quochuy2204/magnetic-sensor/doc/ESD.pptx

## Magnetic contact switch for door

Embedded System Design

## Team members

Do Xuan Vy
e1801589
Tran Minh Hien
e1601116
Nguyen Quoc Huy
e16011

## Introduction

Automation
Remotely monitor door in houses and offices
Security
Data from the sensor can be used to trigger alarm in case of intrusion

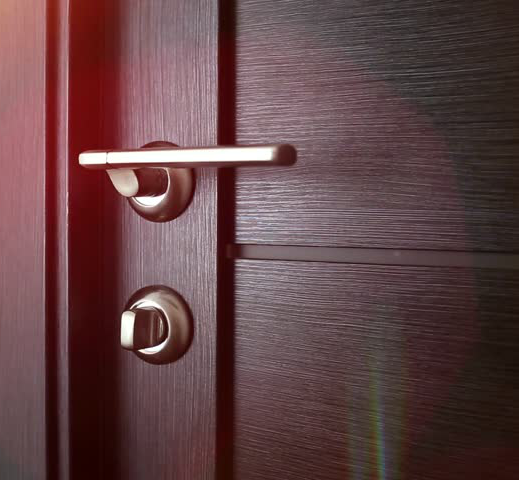
[picture p1: figure]

## Specification

Sensor
Communication
Magnetic sensor with STM32 controller
Wireless communication via XBee Modules

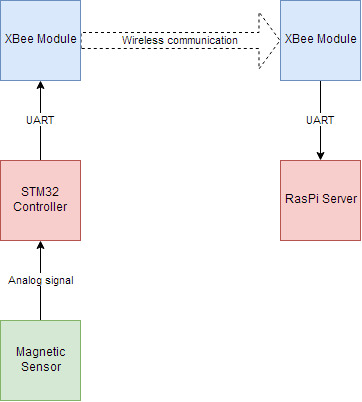
[picture p2: figure]

## Slide 5

## Slide 6

## Slide 7

## Slide 8

## Slide 9

## Slide 10

## Slide 11

## Slide 12

## Slide 13

## Slide 14

## Slide 15

## Slide 16

## Slide 17

## Slide 18

## Slide 19

## Slide 20
