quochuy2204/magnetic-sensor/ESD_report.pdf

GROUP 2

# Embedded Systems Design

Magnetic sensor for doors

April 2019

Do Xuan Vy (e1801589)

Tran Minh Hien (e1601116)

Nguyen Quoc Huy (e160)

VAASAN AMMATTIKORKEAKOULU
VAASA UNIVERSITY OF APPLIED SCIENCES Bachelor of Engineering

ABSTRACT

Author | Tran Minh Hien, Do Xuan Vy, Nguyen Quoc Huy
Title | Magnetic field sensor for doors
Year | 2019
Language | English
Pages | 40
Name of Supervisor | Jani Ahvonen

This is the report of Final project in Embedded Systems Design class. The goal of this course was to get student familiar with STMicroelectronics line of STM32 microcontroller, as well as developing some small projects by using STM32CubeMX software, Attolic TrueStudio for STM32 and vary of simple components such as LM741 operational amplifier, BC547 transistor, ESP-05 WiFi module …

In more detail for this final project, we will manufacture a magnetic measurement system which can be used to detect whether there is a magnetic field moving near the system. The system is a magnetic field measurement device which can detect electromagnetic fields strength spread from magnet stick on the door and then send wireless messages to subsystem which located one 30 meters away indoor and up to 90 meters outdoor by using XBee. At the first park of the system, Magnetic Field Processing (1), handle analog data from sensor then convert it to Hexadecimal. The second park receive the signal from (1), analysis and display the result on screen and alert user status of the door.

The idea of this product is to establish a security device into the doors, which can confirm if the door is closed and can notify users if they forget to close; and beyond, it can help users control the opening and closing via magnetic lock.

CONTENT

INDEX OF FIGURES

INDEX OF TABLES

### TERMS AND ABBREVIATIONS

UART | Universal Asynchronous Receiver-Transmitter
GPIO | General-Purpose Input/Output
SRAM | Static Random-Access Memory
OpAmp | Operational Amplifier
PCB | Printed Circuit Board
IDE | Integrated Development Environment
HAL library | Hardware Abstraction Layer Library

I. INTRODUCTION
The main processor is | STM32L432KCU6. | XBee wireless module was used to

transmit and received data over the air. The magnetic sensor is G-MRCO-028. This

report included block diagram of the hardware design and circuit diagram for

electronic components. The sleep mode of ARM micro controller and XBee module

were also operated so that the system would wake-up arm by itself every single time

a signal was transmitted to reduce the power consumption of the battery-powered

device.

II. PRE-DESIGN

### 1. Block diagram

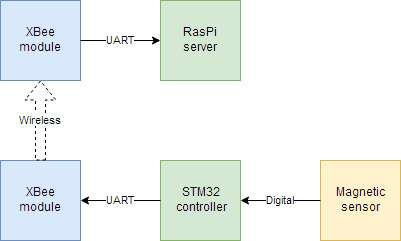
[picture p3: figure]

Figure II.1.1: A block diagram of the device

First of all, the team designed a block diagram to preliminary description system.

There are 3 main parts: The STM32L432KC, XBee, and magnetic sensor. As can

be seen, the diagram above shows the main equipment’s used in the magnetic field

processing device, and how they communicate with each other.

### 2. Components

a. G-MRCO-028

Figure II.2.1:

G-MRCO-028

Pin | Symbol | Function
1 | Vo+ | positive output voltage
2 | GND | negative supply voltage
3 | Vo- | negative output voltage
4 | Vcc | positive supply voltage

Table II.2.1: G-MRCO-028 pin order

G-MRCO-028 (also known as KMZ10CM) is the name of the magnetic field

sensor. This device is use for identifying and measuring magnetic field from

surroundings environment. There are numerous different kind of MS in the market

but we chose G-MRCO-028 because it has enough features to meet our needs such

as:

- Linear signal output
- Over increased field range
- Very low hysteresis
- High sensitivity

Because of its featured properties - high sensitivity and almost no hysteresis – the

G-MRCO-028 sensor is used in a wide range of applications, like magnetic field

measurement, revolution counters, proximity detection, and position measurement.

It is also simple to develop more features for the current device in the future.

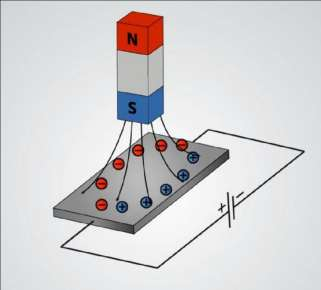
[picture p4: figure]

Figure II.2.2: G-MRCO-028 pin order

G-MRCO-028 works based on Hall Effect principle. When a conductor with a

running current is placed into a magnetic field, a voltage difference appears

perpendicular to the current.

Based on this effect, a Wheatstone bridge is used to detect the magnetic field in the

environment. The strength of the magnetic field is determined by measuring the voltage differential between the two bias. In this project, the sensor is connected to

the differential ADC on the STM32

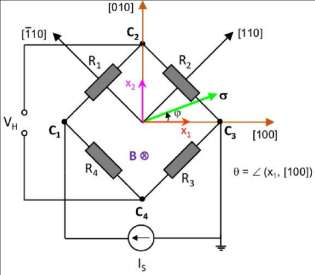
[picture p5: figure]

Figure II.2.3: G-MRCO-028 pin order

b. XBee wireless communication module

XBee is considered a communication device which transmit data by radio wave in

long distance but very low hysteresis. The module was designed to meet

IEE802.15.4 standards and support the individual need of low-cost, low-power

wireless sensor networks.

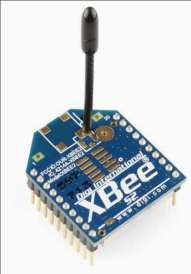
[picture p6: figure]

Figure II.2.4: XBee module

With range 30m indoor and 90 m outdoor. Also support point-to-point, point-to-

multipoint and peer-to-peer topologies supported. XBee is our first choice for

dispatching data and communicating from device to device.

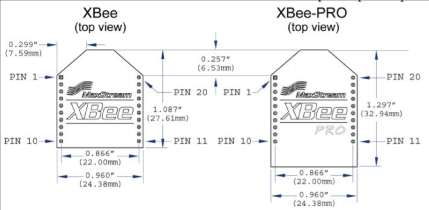
[picture p7: figure]

Figure II.2.5: XBee module pin numbers

c. STM32 L432KC

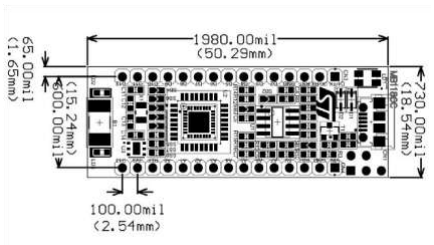
[picture p8: figure]

Figure II.2.6: STM32 L432KC layout

Using provided tools to configure and generate driver code is emerging from

numerous microcontrollers as a new trend. And one of the famous tools at the

moment is STM32Cube-Mx from ST. It helps developer limit down the possible

choices when selecting a microcontroller.

The STM32L432 appliance is the ultra-low-power microcontrollers based on the

high-performance Arm® Cortex®-M4 32-bit RISC core operating at a frequency

of up to 80 MHz. Beside with various outstanding features such as:

- High-speed memories (Flash memory up to 256 Kbyte, 64 Kbyte of SRAM)
- Fast 12-bit ADC (5 Msps)
- Two comparators, one operational amplifier, Two DAC channels
- Low-power RTC
- A general-purpose 32-bit timer

The STM32L432 devices embed numerous protection mechanisms for embedded

Flash memory and SRAM: readout protection, write protection, proprietary code

readout protection and Firewall, improve the security of the system.

III. HARDWARE

### 1. Sensor circuit

a. Design

The goal of the sensor circuit is to turn the analog signal from the magnetic sensor

into a digital signal that can trigger the STM32 controller to send the data to the

server, so that the STM32 can avoid having to pool for the sensor value

continuously while still maintain the instancy in notifying the server when the state

of the door is changed.

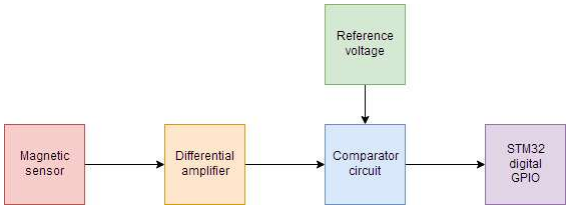
[picture p9: figure]

Figure III.1.1: Block diagram for the sensor circuit

This goal is achieve by using two OpAmp circuit: a differential amplifier and a

comparator circuit. The differential amplifier will get the differential voltage

between the two outputs of the sensor and magnify it. The comparator will compare

the value from the previous circuit with a reference voltage value. The reference

voltage will come from a voltage trimming circuit.

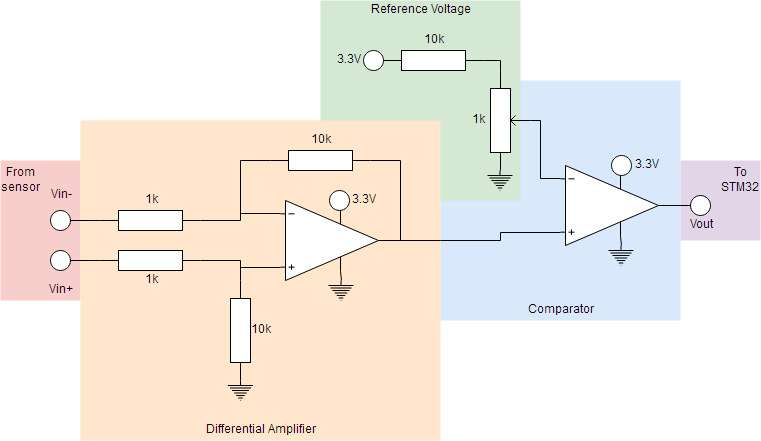
[picture p10: figure]

Figure III.1.2: Circuit diagram for the sensor circuit

The output of the differential amplifier will be:

Vdiff =

10
1

Vin+ −

10
1

Vin− = 10(Vin+ − Vin−)

The maximum voltage from the reference voltage will be:

Vref,max = 3.3 ×

1
10 + 1

= 0.3 V

According to experimenting result with available magnets in the lab, the sensor’s

output range may go up to about 20 mV, which bring the maximum Vref to about

0.2 V.

b. Simulation

The design circuit was simulated on LTSpice. In the simulation, Vin+ is replaced by

Vsweep, and Vin− was replaced by Vbase producing 1.6 V. The circuit was then run

with DC sweep on Vsweep from 1.6 to 1.7 V.

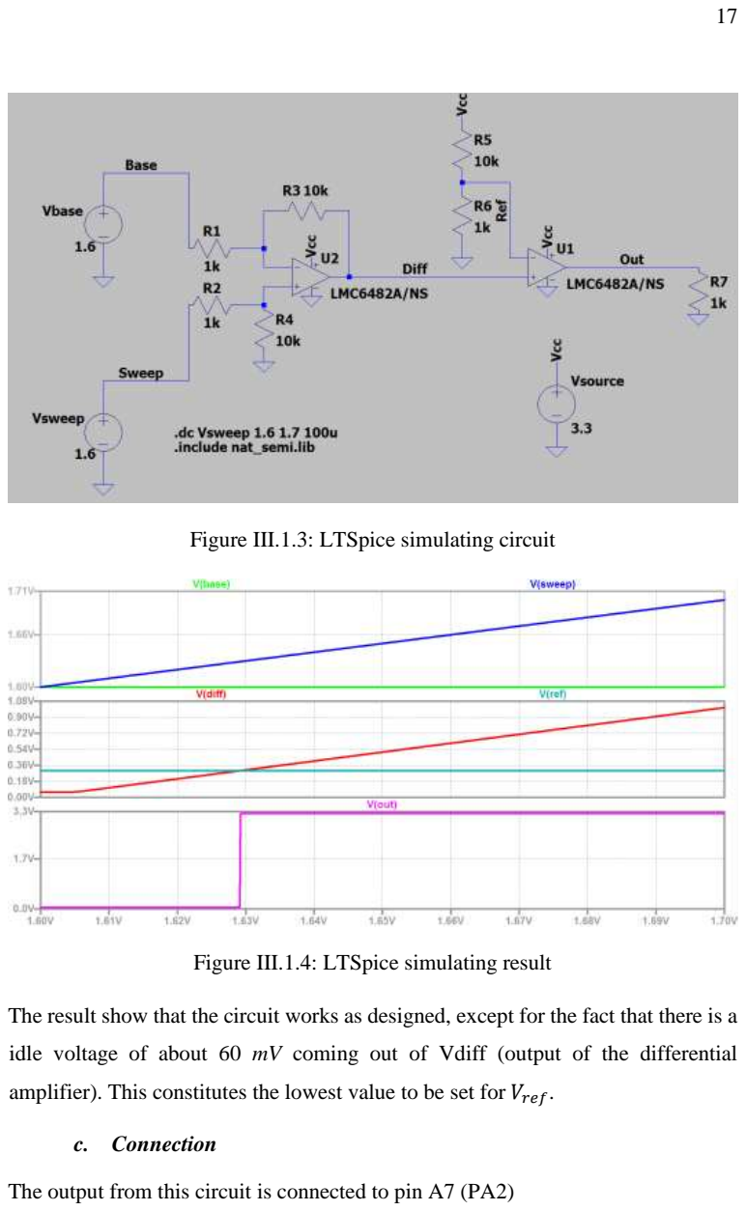
[picture p11: page 17]

Figure III.1.3: LTSpice simulating circuit

Figure III.1.4: LTSpice simulating result

The result show that the circuit works as designed, except for the fact that there is a

idle voltage of about 60 mV coming out of Vdiff (output of the differential

amplifier). This constitutes the lowest value to be set for Vref.

c. Connection

The output from this circuit is connected to pin A7 (PA2)

### 2. XBee connection

The XBee module is directly connected to the STM32. There are five connection

needed to be made: Vcc (3.3 V), ground, UART transmit/receive, and pin doze (to

put the XBee into sleep mode). The connection is specify in the following table:

XBee pin name | XBee pin number | STM32 pin | STM32 GPIO port | Function
VCC | 1 | 3.3V | | Power supply
GND | 10 | GND | | Ground
DOUT | 2 | D2/RX | PA10 | UART
DIN | 3 | D1/TX | PA9 | UART
SLEEP_RQ | 9 | D9 | PA8 | Sleep mode

Table III.2.1: Connection from XBee module to STM32 controller

### 3. Power supply

All components on the board will be powered via STM32 controller’s 3.3 V power

pin, which in turn are stabilize by the STM32’s inner power regulator.

To power the controller, there are three voltage option: 3.3V, 5V, or 7V-12V. In this

project. At the start, the project was planned to be powered by a series of 3.3V

button batteries. However, the batteries could not provide the needed current.

Due to this, the 7V-12V option is used, and the circuit is power with a more powerful

9V battery via Vin pin. For the voltage range from 7V to 9V that the battery can

provide, the maximum current draw is 450 mA. From experimenting, it was

determined that the maximum current consume by the entire circuit does not exceed

130 mA.

The connection between the battery and the STM32 is also protected by two

decoupling capacitors: one 10 μF electrolyte and one 100 nF ceramic capacitor. A

MF-MSMF050-2 resettable fuse is also used as a circuit breaker.

### 4. Testing

After designing, the whole circuit was put on breadboard and tested.

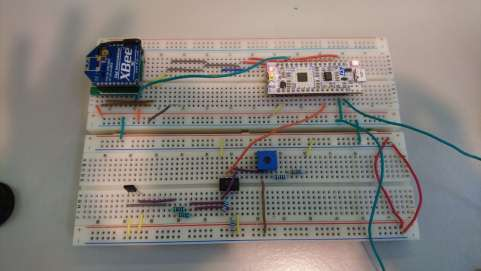
[picture p12: figure]

Figure III.4.1: The whole circuit put on breadboard

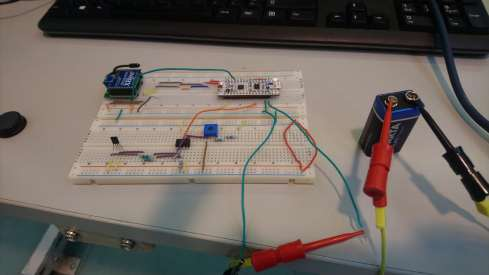
[picture p13: figure]

Figure III.4.1: Testing the circuit with a 9V battery

The circuit fulfill the following criteria:

- The sensor can detect a magnet and generate the correct signal
- The STM32 can connect to the XBee module
- The STM32 can be powered by the battery with a current stable enough for

the UART communication between the STM32 and the XBee

PCB is one of the most important factors, it makes everything simple and neat, for

that reason the team has spent a lot of time to design and fix it.

### 5. Circuit diagram for electronics (PADS Logic)

There are 5 parts in this final project system layout:

a. STM32L432KCU6 development board
This is the main processor of the whole system, which is small, convenient and

powerful for input data processing, data transfer for necessary modules as well as

controlling the entire system

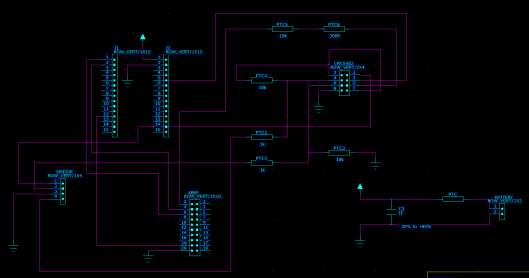
[picture p14: figure]

Figure III.5.1: PADS Logic schematic of the system

Because there is not pattern of this kind of components in the library of PADS, we

have to design them by ourselves. We used 2 rows 15 pins stand for the STM32 board. The 2 first pins and the 12th pin on the left connected with XBee module.

The 2 first pins on the right are connected to 9V power and ground. The 14th pins

on the right is the 3.3V power of sensor, XBee and LMC6482.

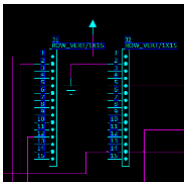
[picture p15: figure]

Figure III.5.2: STM32 board on PADS Layout

b. G-MRCO-028 sensor
This is the magnetic sensor, which can measure and feedback the signal of change

in magnetic field around it.

We used 1 row 4 pins stand for the sensor. The 1st pin is linked with 3.3V power of

STM32, the 3rd pin is linked with ground. The 2nd and 4th pins are output voltage

which is connected to the OpAmp LMC6482 to gain an amplifier signal output

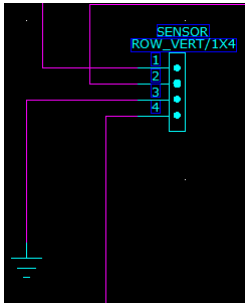
[picture p16: figure]

Figure III.5.2: G-MRCO-028 sensor on PADS Layout

c. XBee module
This is the wireless module to transmit and received data through radios.

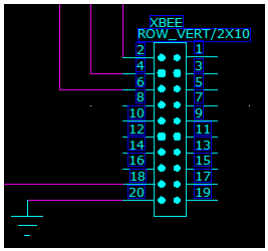
[picture p17: figure]

Figure III.5.3: XBee module on PADS Layout

We used 2x10 pins row stand for XBee. The 1st pin on the left is connected with

3.3V power of STM32, the 2nd and 3rd pins on the left are UART data pins, which

is linked with STM32. The 9th pin is sleep mode control pin, which is linked with

STM32. And the last one connects with ground.

d. LMC6482 OpAmp
This is the OpAmp to produce a potential larger than the input terminals. There are

2 OpAmps in this LMC6482

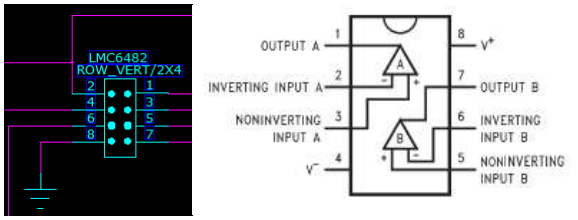
[picture p18: figure]

Figure III.5.4: LM6482 OpAmp on PADS Layout

8

th pin is connected to the ground. 2nd ,4th ,6th pin is of the first OpAmp. 3rd, 5th, 7th

is of the second OpAmp. 1st pin is connected to the 3.3V power of STM32

e. Power

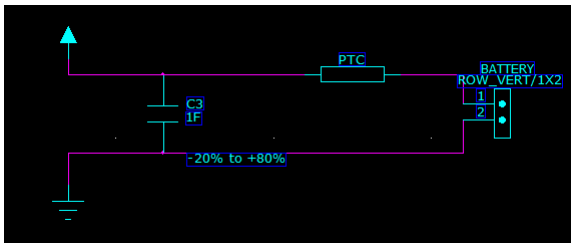
[picture p19: figure]

Figure III.5.5: Power supply on PADS Layout

The power system used a 9V battery. We added a PPTC Resettable Fuse at the

positive power pin to protect the components of product if there is some power

problems. It also got a capacitor between positive power line and ground for

capacitive coupling

### 6. PCB design and cooper pour (PADS Layout)

After draw by using PADS layout, we linked the schematic to PADS logic and start

to design the PCB.

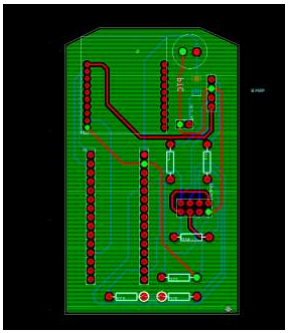
[picture p20: figure]

Figure III.6.1: Bot side PCB with copper pour

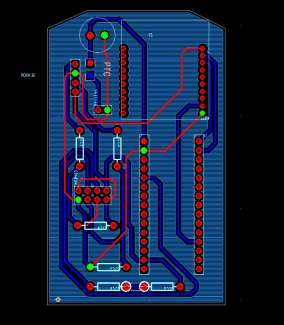
[picture p21: figure]

Figure III.6.2: Top side PCB with copper pour

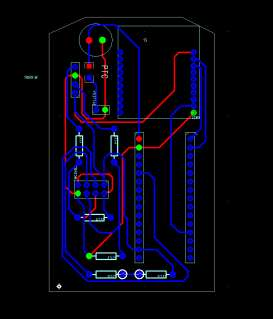
[picture p22: figure]

Figure III.6.3: PCB without copper pour

### 7. PCB printing and finalize product

The goal of this project is that the whole system must be fit into the Starelec box

1591A-FL. The team measured the technical data of the equipment and PCB

dimensions and tried to optimize the space to fit the project requirements.

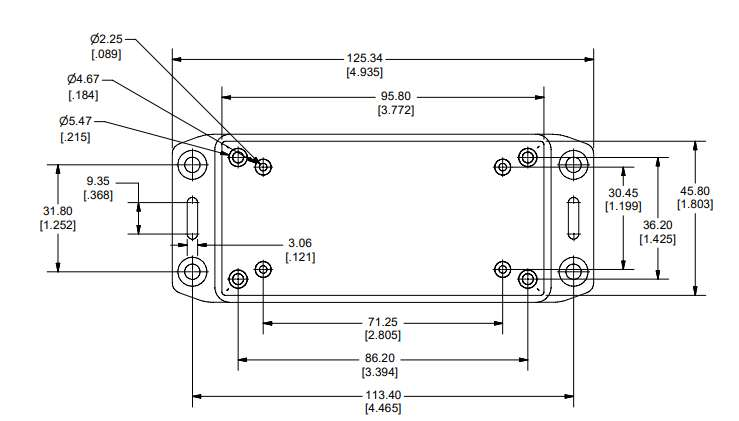
[picture p23: figure]

Figure III.7.1: Technical sketch of the Starelec box base

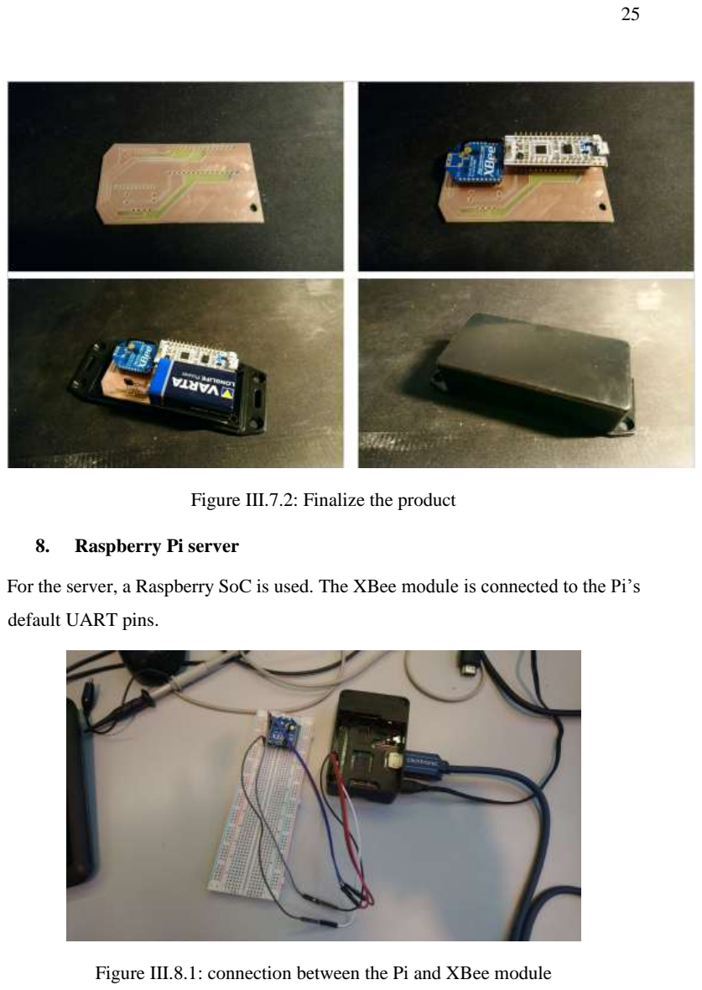
[picture p24: page 25]

Figure III.7.2: Finalize the product

### 8. Raspberry Pi server

For the server, a Raspberry SoC is used. The XBee module is connected to the Pi’s

default UART pins.

Figure III.8.1: connection between the Pi and XBee module

IV. SOFTWARE

### 1. IDE

The main software developing tools used in this project are:

- STM32CubeMX: | Official | code | generating | application | from

STMicroelectronics, the main manufacturer of STM32 development boards.

Generating code template and configure peripherals on the STM32 board.

- Atollic TrueSTUDIO: an IDE based on Eclipse, GNU gcc and gdb, used to

compile the code and flash the STM32 with the compiled .elf file, as well as

run and debugging the code on the board via ST-LINK

- Rasbian: The most common OS for Raspberry Pi, providing important

application for programming the RasPi server such as nano, python, etc…

### 2. XBee settings

The settings of the XBee is as in the following table

Setting | AT command | Client XBee | Server XBee
16 bit address | MY | AB02 | AB01
Channel | CN | C | C
Sleep mode | SM | 2 (pin doze) | 0 (no sleep)
UART baud rate | BD | 3 (9600) | 3 (9600)

Table IV.2.1: settings for XBee modules

The two modules are set to have two different address. Sleep mode is enable on

client XBee module

### 3. Client side

a. Hardware configure with STM32CubeMX

All GPIO used in the project is listed in the following table

Pin name | Pin GPIO port | Pin mode | Function
A7 | PA2 | GPIO_EXTI2 | Receive data from sensor
D9 | PA8 | GPIO_Output | Controll XBee’s pin doze
D1/TX | PA9 | USART1_TX | UART transmit to XBee
D2/RX | PA10 | USART1_RX | UART receive from XBee

Table IV.3.1: Summary of GPIO usage on STM32 controller

Pin A7 is set in interrupt mode to wake the STM32 when the state of the door is

changed. Pin D9 is connected to XBee pin 9 (pin doze) to put the XBee to sleep

when there is no communication need. Pin D1/TX and D2/RX are two UART serial

pins, connected to DIN and DOUT on the XBee, respectively. The UART

interfaced used is UART1, at baud rate 9600, configuration 8-N-1, without flow

control.

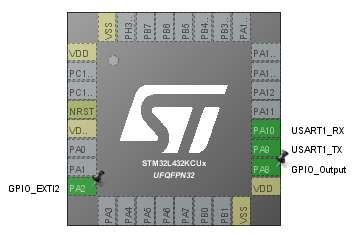
[picture p25: figure]

Figure IV.3.1: GPIO setting on STM32CubeMX

b. XBee API interface
i. XBee API frame

Figure IV.3.2: Layout of one API frame

One frame of XBee API’s communication mode is consisted of four parts:

- Start delimiter (1 byte, 0x7E): signal the start of one frame
- Length (2 byte, big endian): specify the length of the frame data, not

including the delimiter, the length itself, and the checksum byte

- Frame data: the data in the frame, has specific structure depending on the

API function

- Checksum (1 byte): to verify the integrity of the frame. The checksum is

calculated by taking the sum of all bytes in the frame data, take only the

lowest 8 bits, and subtract that value by 0xFF. If a frame has invalid

checksum, it will be discarded completely by the XBee module

ii. XBee transmit request for 16-bit address

This frame will be send from the STM32 controller to the XBee module to initiate

sending a packet to the server

Figure IV.3.3: Layout of one transmit request for 16-bit address frame

A transmit request for 16-bit address has five fields in its frame data:

- API identifier (0x01, 1 byte): specify the API function
- Frame ID (1 byte): specify the frame ID for the host to reply with an ACK

frame

- Destination address (2 bytes): specify the receiving module’s address
- Option (1 byte): has two flag
- 0x01: enable the ACK response if set
- 0x04: send packet with PAN broadcast ID if set
- RF data (maximum 100 bytes): data to be sent

iii. XBee.h and XBee.c

Inside the XBee.h and XBee.c files are a few functions taking care of the

communication from the STM32 to the XBee client module.

Figure IV.3.4: XBee.h source code

In XBee.h two function are defined to be used in the main program. These two

functions are:

- init_XBee: register the UART handle to be used to communicate with the

XBee module

- Arguments:
- huart (UART_HandleTypeDef*): pointer to the UART

handle to be used

- tx_req_XBee: make a transmit request to the XBee
- Arguments:
- id (uint8_t): frame ID
- addr (uint16_t): destination address
- opt (uint8_t): options
- data (char*): data to be sent

The definition of these function is shown in the following figure

#ifndef XBEE_H

#define XBEE_H

#include "stm32l4xx_hal.h"

#define XBEE_BUFFER_LENGTH 100

void init_XBee(UART_HandleTypeDef* huart); void tx_req_XBee(uint8_t id, uint16_t addr, uint8_t opt, char* data);

#endif

#include "XBee.h"

#include "stm32l4xx_hal.h"

#include "string.h"

// global pointer to the UART handle used to communicate with the XBee
UART_HandleTypeDef* huart_g;

// put an unsigned 16 bit number onto a position in an uint8_t array
void put_int16(uint8_t* pos, uint16_t num) {
pos[0] = (num & 0xFF00) >> 8; pos[1] = num & 0xFF;
}

// concatenate a char array into a uint_8 array at position defined by offset
void concat_XBee(uint8_t *buf, char* data, size_t offset) {
for (size_t i = 0; data[i]; i++) { buf[i + offset] = data[i]; }
}

// save the huart used to communicate with the XBee void init_XBee(UART_HandleTypeDef* huart) { huart_g = huart;
}

// send one API frame to the XBee, with checksum calculation
// take two arguments: data (uint8_t array) and len (size_t)
void send_XBee(uint8_t *data, size_t len) {
// the buffer of data to be sent uint8_t buf[XBEE_BUFFER_LENGTH]; // the sum of the frame data values uint16_t sum = 0;

// starting delimiter
buf[0] = 0x7E;

// length
put_int16(buf + 1, len);

// copying the data into the buffer and taking the total sum of the frame data values for (size_t i = 0; i < len; i++) {
buf[i + 3] = data[i];
sum += data[i];
sum &= 0xFF;
}

// calculate the checksum
buf[len + 3] = 0xFF - sum;

// send the buffer to the XBee via UART HAL_UART_Transmit(huart_g, buf, len + 4, 100); }

Figure IV.3.5: XBee.c source code

c. Minimize power usage

To minimize power usage, the following methods was taken

i. Put unused pins into analog mode

Unused pins can be set in analog mode in the STM32CubeMX

ii. Disable unused GPIO

Figure IV.3.6: source code for function disable_gpio in main.c

The pins used in this project was chosen so that only GPIO port A is needed,

therefore GPIO port B and C can be disabled.

// send one API transmit request to the XBee
void tx_req_XBee(uint8_t id, uint16_t addr, uint8_t opt, char* data) {
// the buffer contain the frame data uint8_t buf[XBEE_BUFFER_LENGTH];

// API identifier
buf[0] = 0x01;
// frame ID
buf[1] = id;
// destination address
put_int16(buf + 2, addr);
// options
buf[4] = opt;

// copying the data to be sent into the buffer concat_XBee(buf, data, 5);

// send the frame data to the XBee send_XBee(buf, strlen(data) + 5);
}

void disable_gpio() {
// GPIO struct to be set to GPIO ports GPIO_InitTypeDef GPIO_InitStructure = { 0 }; GPIO_InitStructure.Pin = GPIO_PIN_All; GPIO_InitStructure.Mode = GPIO_MODE_ANALOG; GPIO_InitStructure.Pull = GPIO_NOPULL;

// disable GPIO_B
HAL_GPIO_Init(GPIOB, &GPIO_InitStructure); // disable GPIO_B clock
__HAL_RCC_GPIOB_CLK_DISABLE();
// disable GPIO_C
HAL_GPIO_Init(GPIOC, &GPIO_InitStructure); // disable GPIO_C clock
__HAL_RCC_GPIOC_CLK_DISABLE();
}

iii. Put XBee to sleep

The client XBee module is set into sleep mode 2 (ATSM 2 - pin doze). This mode

consume more power but has a shorter wake up time. When in this mode, pin 9

(SLEEP_RQ) will put the XBee to sleep if its value is high, and wake the XBee if

the value is low. This pin is control by pin D9 (PA8) on the STM32

iv. Put STM32 to sleep

Figure IV.3.7 source code for function enter_sleep_mode in main.c

In order to put the STM32 to sleep, the function HAL_PWR_EnterSLEEPMode is

used. This function take two arguments:

- PWR_MAINREGULATOR_ON: choose the regulator in sleep mode, either

the main regulator or the low power regulator. In this project, the main

regulator is used for sleep mode

- PWR_SLEEPENTRY_WFI: choose the Cortex-M sleep instruction, either

WFI or WFE. In this project, the WFI instruction is used, which will wake

the STM32 both on event or on registered interrupt

All interrupt that was not intended to wake the STM32 up must also be disabled. In

this case, the SysTick timer interrupt must be disable by the function

HAL_SuspendTick. If HAL_Delay is use after wake up, this interrupt must be re-

enable by the function HAL_ResumeTick

// enter sleep mode
void enter_sleep_mode() {
// put XBee to sleep
HAL_GPIO_WritePin(GPIOA, GPIO_PIN_8, GPIO_PIN_SET);

// disable SysTick interrupt
HAL_SuspendTick();

// put the STM32 into sleep mode HAL_PWR_EnterSLEEPMode(PWR_MAINREGULATOR_ON, PWR_SLEEPENTRY_WFI);

// after wake up
// wake the XBee
HAL_GPIO_WritePin(GPIOA, GPIO_PIN_8, GPIO_PIN_RESET);

// enable Systick interrupt HAL_ResumeTick();

// wait for the XBee wake up time HAL_Delay(2);
}

The function enter_sleep_mode also contain the code to put XBee to sleep.

v. Result

After setting up the sleep mode, total current drain was measure at the connection

with the battery. The results are shown below

- In sleep mode: 60mA
- Out of sleep mode: 110mA
- Wake time to send one package to the server: 120ms

With the battery capacity of 500mAh, this client can last 500
60

=

8 ℎours 20 minutes, which is not commercially acceptable.

Further inspection review that while the XBee was put to sleep and drain a current

of less than 1mA, the STM32 still pulling a current of more than 50mA, while its

logical behavior is identical to being in sleep mode. Upon consulting another group

with a similar solution, it seems that a similar software can put their STM32 into

sleep mode with lower than 1 mA drain. The only difference is that while our

solution use a 9V battery, they use a 3.3V battery. This may show that the ST-LINK

was not properly shutdown during sleep mode in our software.

d. Main function

Figure IV.3.8 key source code in main.c

In the main function, after setting up all the peripherals:

- Sensor interrupt pin is pull down to 0 in order for the interrupt to register
- Init XBee with the right UART handle
- Disable unused GPIO
- Enter the main program loop

/* USER CODE BEGIN 2 */

// pull down sensor interrupt pin HAL_GPIO_WritePin(GPIOA, GPIO_PIN_2, GPIO_PIN_RESET);

// register the UART handle used to speak to XBee init_XBee(&huart1);

// disable unused GPIO ports
disable_gpio();

/* USER CODE END 2 */

/* Infinite loop */
/* USER CODE BEGIN WHILE */ while (1) {
/* USER CODE END WHILE */

/* USER CODE BEGIN 3 */
// current door status, old door status int stt, old_stt;

// read current door status
stt = HAL_GPIO_ReadPin(GPIOA, GPIO_PIN_2);

do {
// record old door status
old_stt = stt;

// send XBee package depend on the door status
if (stt == GPIO_PIN_SET) { tx_req_XBee(1, 0xAB01, 0, "2+1"); } else {
tx_req_XBee(1, 0xAB01, 0, "2+0"); }

// read new door status
stt = HAL_GPIO_ReadPin(GPIOA, GPIO_PIN_2);

// only exit if the status of the door is not changed during XBee transmission } while (stt != old_stt);

// enter sleep mode
enter_sleep_mode();

/* USER CODE BEGIN 3 */
}

In the loop, another loop is used to repeatedly send new update to the server if the

state of the door is changed while XBee is doing transmission. This is to prevent

cases when the sensor fluctuate and the last state of the door is not correctly

registered to the server.

### 4. Server side

a. XBee receive frame for 16-bit address

This frame will be receive by the Raspberry Pi server when a package is receive by

the sever XBee module.

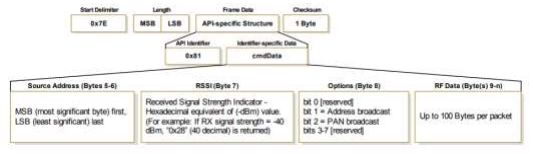
[picture p26: figure]

Figure IV.4.1: Layout of one receive frame for 16-bit address frame

A receive frame for 16-bit address has five fields in its frame data:

- API identifier (0x80, 1 byte): specify the API function
- Source address (2 bytes): specify the sending module’s address
- RSSI (1 byte): show the signal strength of the received package
- Option (1 byte): has two flag
- 0x02: set if the package was sent to broadcast adress
- 0x04: set if the package was sent with PAN broadcast ID
- RF data (maximum 100 bytes): data received
b. Config.py

Config.py is a python script that can open an AT command console to the connected

XBee module. Using this file, a user can modify the XBee settings without needing

a dedicated connector.

Figure IV.4.2: source code in config.py

#! /usr/bin/python3

import sys
import serial
import time

# define the serial port to connect to the XBee XBee = serial.Serial('/dev/ttyS0', 9600)

# send the ‘+++’ string to enter command mode def enter_cmd_mode():

print('Getting XBee into command mode ...') XBee.write(b'+++')
count = 0
while XBee.inWaiting() < 3:
count += 1
time.sleep(0.01)
if count > 500:
break
recv = XBee.read(3)
if XBee.inWaiting() > 0 or recv != b'OK\r': raise RuntimeError('Error getting XBee into command mode')
print('XBee is now command mode')

# send raw data to the XBee

def send_raw(cmd):
XBee.write(cmd.encode('UTF-8'))

# receive raw data from the XBee

# return a string instead of a bytes array def recv_raw():

count = 0
while XBee.inWaiting() < 1: count += 1
time.sleep(0.01)
if count > 1000:
print("Receive timeout")
enter_cmd_mode()
break
len = XBee.inWaiting()
time.sleep(0.01)
while XBee.inWaiting() != len:
len = XBee.inWaiting()
time.sleep(0.01)
return XBee.read(len).decode('UTF-8')

# the main function for the console def main():

enter_cmd_mode()
while True:
line = sys.stdin.readline().rstrip() send_raw("{}\r".format(line)) reply = recv_raw().rstrip() print(reply)

# run only if this file is executed, not imported if __name__ == '__main__':

try:
main()
# exit on Ctrl+C press

except KeyboardInterrupt:
print()
print('Good bye!')

c. Server.py

Config.py is a python script that start a server to receive data from the client and

display it onto the screen.

Figure IV.4.3: source code in server.py

#!/usr/bin/python3

import serial
from time import sleep

# define serial port to the XBee

XBee = serial.Serial ("/dev/ttyS0", 9600)

while True:
# wait till there is data

while XBee.inWaiting() < 1: sleep(0.01)

# read one byte

c = XBee.read()

# if the byte is 0x7E

if c == b"\x7e":
# get length

buf = XBee.read(2)
len = buf[0]*256 + buf[1]

# get API identifier

apid = int.from_bytes(XBee.read(1), "big") if apid == 0x81:
# get address

addr = int.from_bytes(XBee.read(2), "big")

# get signal strength

str = int.from_bytes(XBee.read(1), "big")

# get option

opt = int.from_bytes(XBee.read(1), "big")

# get data

data = XBee.read(len-5).decode("UTF-8").rstrip()

# if the package come from the right address and has the right format if addr == 0xAB02 and data[:2] == "2+": value = data[2]

# display the door status

if value == '1':
print("Door closed")
else:
print("Door open")

V. PRICING

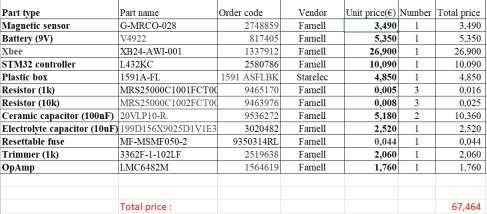
[picture p27: figure]

Table V.1.1: List of all hard ware devices

To overcome the challenge of ensuring the functionality of the device with such

constraint on size and components, great consideration was taken by us. We

calculated the size of the device and check datasheet of every single items to ensure

that the components and battery not only fit in 45.8mm x 95.8mm x 19.0mm box.

The table above show the names, order codes and price of all implements. The

actual selling price still have not appraised at the moment but the price between 150

and 200 euro should be good for develop team. Hence, taking 80€ to 130€ benefit

per sale is a big motivation for the company to continue do product research and

development. In the other hand, the company also committed to providing software

support and guarantee security to customers, make them feel worthy of the money.

REFERENCE

Farnell AN AVNET COMPANY. (2019, April 28). NUCLEO-L432KC -

Development Board, STM32L432KC MCU, ST-LINK/V2-1

Debugger/Programmer, Arduino Connectivity. Retrieved from Farnell AN

AVNET COMPANY: https://fi.farnell.com/stmicroelectronics/nucleo-

l432kc/dev-board-nucleo-

32/dp/2580786?ost=L432KC&ddkey=https%3Afi-

FI%2FElement14_Finland%2Fsearch (https://fi.farnell.com/stmicroelectronics/nucleo-l432kc/dev-board-nucleo-32/dp/2580786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)

Mouser Electronics. (2019, April 28). G-MRCO-028 Measurement Specialties |

Mouser Europe. Retrieved from Mouser Electronics:

https://eu.mouser.com/ProductDetail/Measurement-Specialties/G-MRCO-

028?qs=oFx6pF86PmDibzYzasua3w== (https://eu.mouser.com/ProductDetail/Measurement-Specialties/G-MRCO-028?qs=oFx6pF86PmDibzYzasua3w==)

Wikipedia, the free encyclopedia. (2019, April 28). Wheatstone bridge -

Wikipedia. Retrieved from Wikipedia, the free encyclopedia:

https://en.wikipedia.org/wiki/Wheatstone_bridge

Texas Instruments Incorporated. (2015). LMC6482 CMOS Dual Rail-to-Rail

Input and Output Operational Amplifier. Retrieved from ti.com:

https://www.ti.com/lit/ds/symlink/lmc6482.pdf

Digi Internatonal, Inc. (2009). XBee®/XBee-PRO® RF Modules. Retrieved from

sparkfun.com:

https://www.sparkfun.com/datasheets/Wireless/Zigbee/XBee-

Datasheet.pdf (https://www.sparkfun.com/datasheets/Wireless/Zigbee/XBee-Datasheet.pdf)

STMicroelectronics (2019). STM32CubeMX for STM32 configuration and

initialization C code generation. Retrieved from st.com:

https://www.st.com/content/ccc/resource/technical/document/user_manual/

10/c5/1a/43/3a/70/43/7d/DM00104712.pdf/files/DM00104712.pdf/jcr:cont

ent/translations/en.DM00104712.pdf (https://www.st.com/content/ccc/resource/technical/document/user_manual/10/c5/1a/43/3a/70/43/7d/DM00104712.pdf/files/DM00104712.pdf/jcr:content/translations/en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)

STMicroelectronics (2018). Reference manual STM32L4x5 and STM32L4x6

advanced Arm®-based 32-bit MCUs. Retrieved from st.com:

https://www.st.com/content/ccc/resource/technical/document/reference_manual/02/35/09/0c/4f/f7/40/03/DM00083560.pdf/files/DM00083560.pdf/jc

r:content/translations/en.DM00083560.pdf (https://www.st.com/content/ccc/resource/technical/document/reference_manual/02/35/09/0c/4f/f7/40/03/DM00083560.pdf/files/DM00083560.pdf/jcr:content/translatio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)

STMicroelectronics (2018). User manual STM32 Nucleo-32 boards (MB1180).

Retrieved from st.com:

https://www.st.com/content/ccc/resource/technical/document/user_manual/

e3/0e/88/05/e8/74/43/a0/DM00231744.pdf/files/DM00231744.pdf/jcr:cont

ent/translations/en.DM00231744.pdf (https://www.st.com/content/ccc/resource/technical/document/user_manual/e3/0e/88/05/e8/74/43/a0/DM00231744.pdf/files/DM00231744.pdf/jcr:content/translations/en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)
