quochuy2204/magnetic-sensor/doc/ESD presentation.pdf

# Welcome to our presentation!

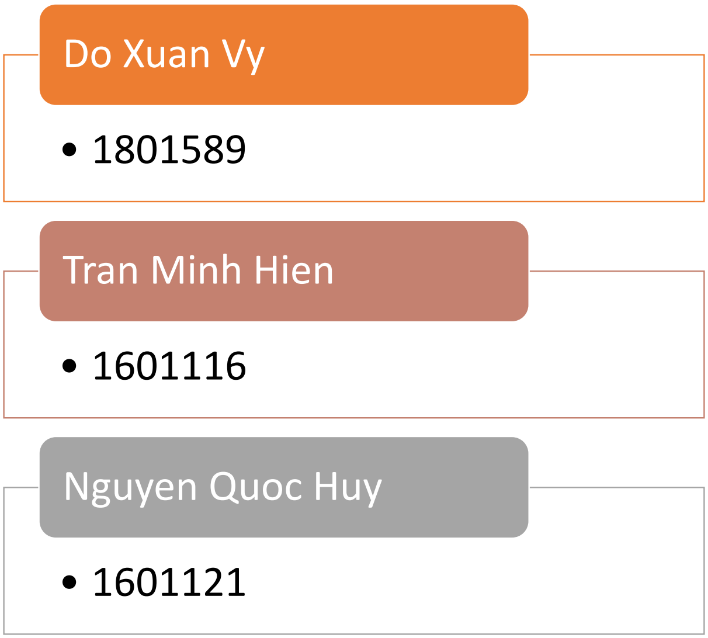
[picture p28: figure]
Do Xuan Vy; Tran Minh Hien; Nguyen Quoc Huy

## 3N2-Group 2

# THE idea

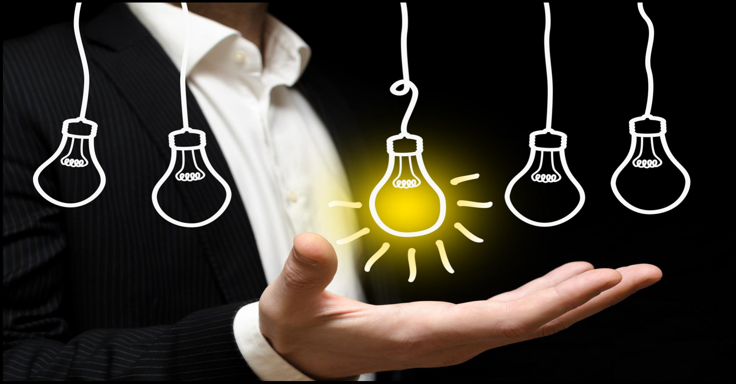
[picture p29: figure]

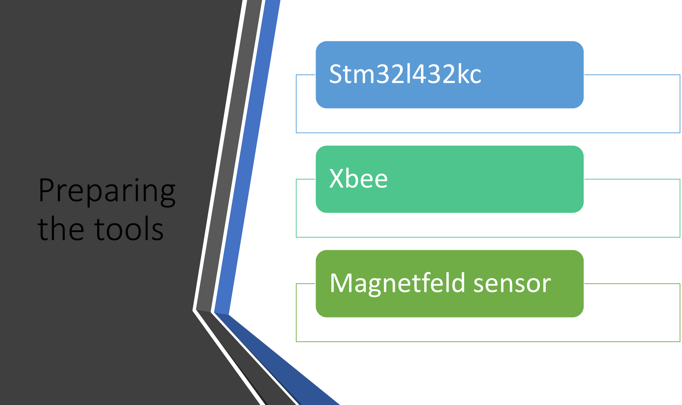
[picture p30: figure]
Preparing the tools; Stm32l432kc; Xbee; Magnetfeld sensor

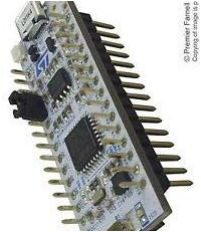
[picture p31: figure]

## Stm32l432kc

- Why we choose Stm32l432kc ? :
- Cheaper than Raspberry.
- Also more featureful.
- Easy to add extra devices.

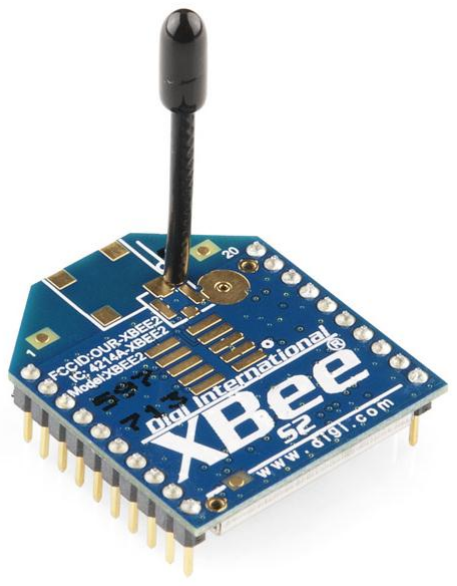
[picture p32: figure]

## XBee

- Xbee has numerous advantages :
- Transmission frequently band 900Mhz and 2.4Ghz
- Indoor/Urban: up to 100’ (30 m)
- Outdoor line-of-sight: up to 300’ (90 m)
- Point-to-point, point-to-multipoint and peer-to-peer topologies supported

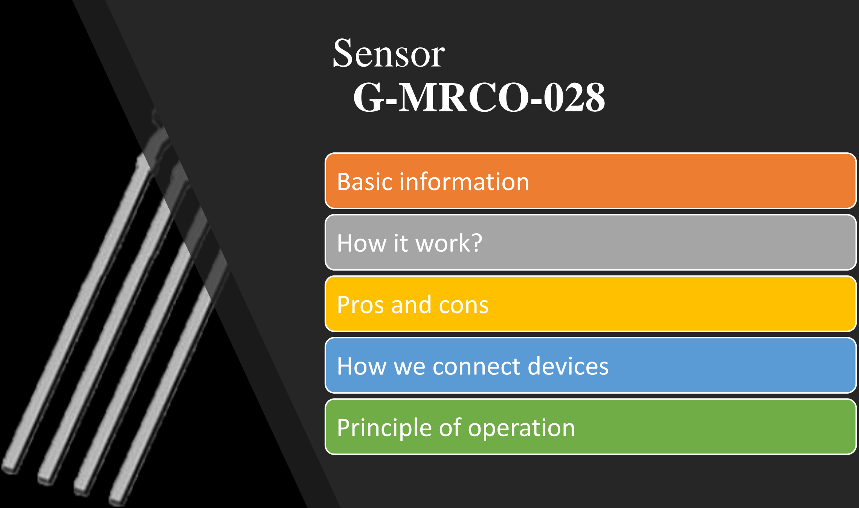
[picture p33: figure]
Sensor G-MRCO-028; Basic information; How it work?; Pros and cons; How we connect devices; Principle of operation

# Basic information

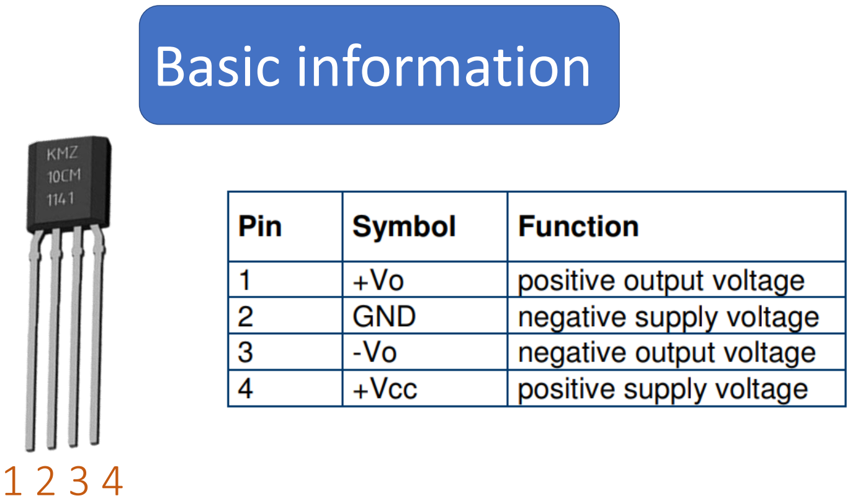
[picture p34: page 8]

1 2 3 4

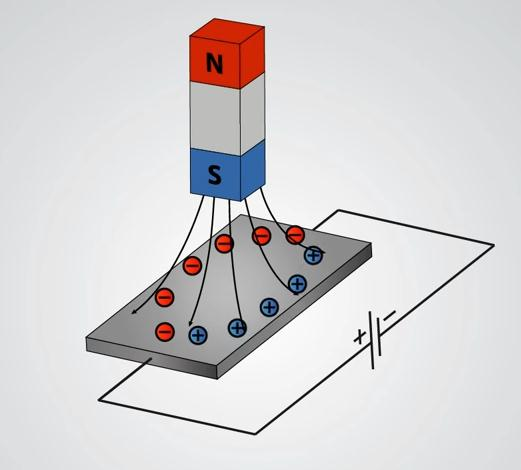
[picture p35: figure]

### Hall Effect

- When a conductor with an running current is placed into a magnetic field, a voltage
difference appears
perpendicular to the current

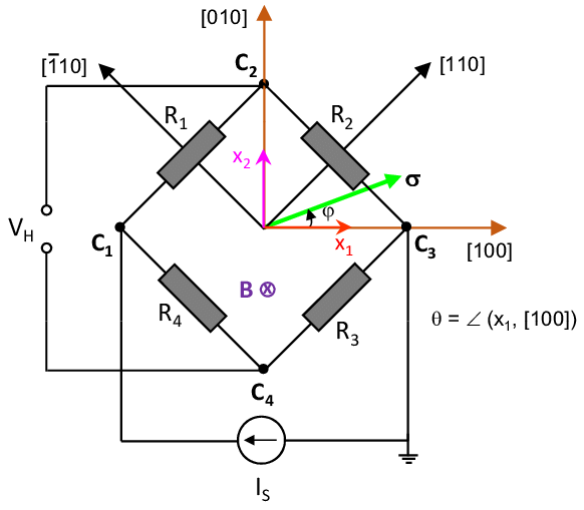
[picture p36: figure]

- Based on this effect, we can use a Wheatstone bridge to detect the magnetic field in the
enviroment
- The strength of the magnetic field is determined by measuring the voltage differential between the two bias
- In this project, the sensor is connected to the differential ADC on the STM32

# Hall Effect Sensor

- Linear signal output
- Over increased field range
- Very low hysteresis
- High sensitivity
- Passive component
(Requite a individual circuit to cut the power of the sensor)
- Require amplifiers to increase the power of signal.

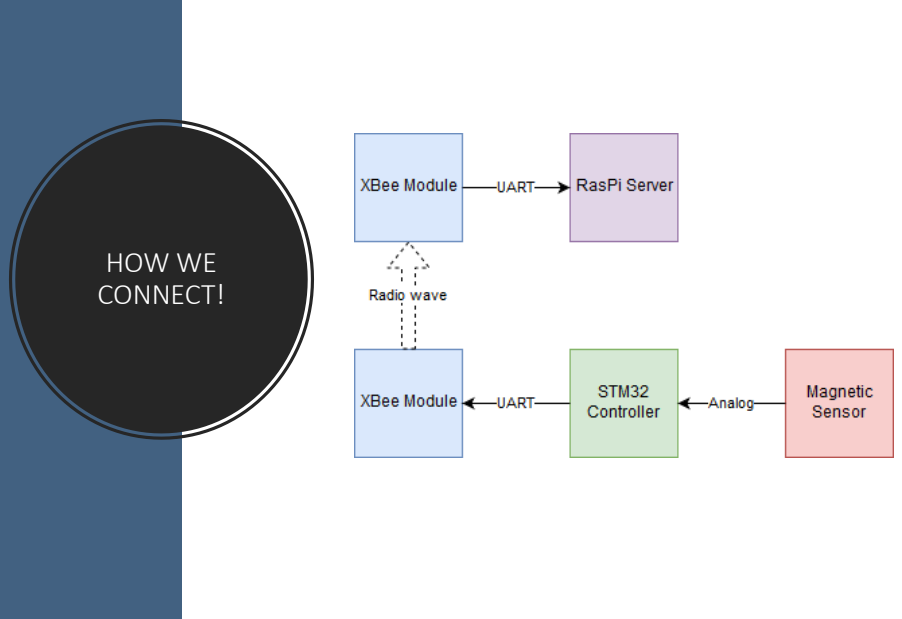
[picture p37: page 12]
HOW WE CONNECT!

# Principle of operation

Record the change of
magnectic field | STM process
| the signal

Xbee send it to the
another Xbee
which connected
to server

Server analysit data
and display result
on screen
Step 1 | Step 2 | Step 3 | Step 4

## </Here is our Block Diagram> (Client side)

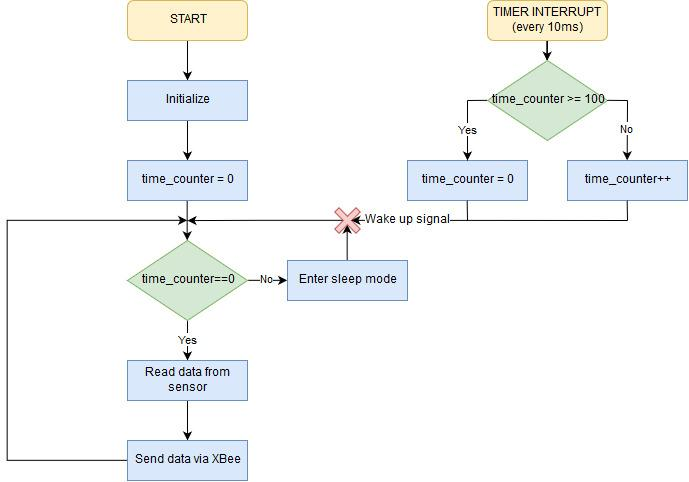
[picture p38: figure]

## </Here is our Block Diagram> (Server side)

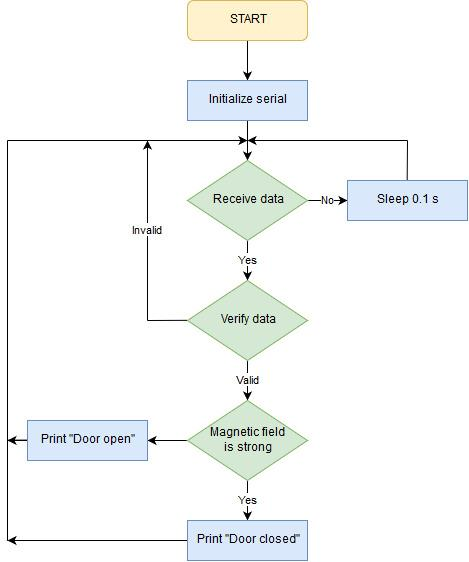
[picture p39: figure]

## Layout schematic

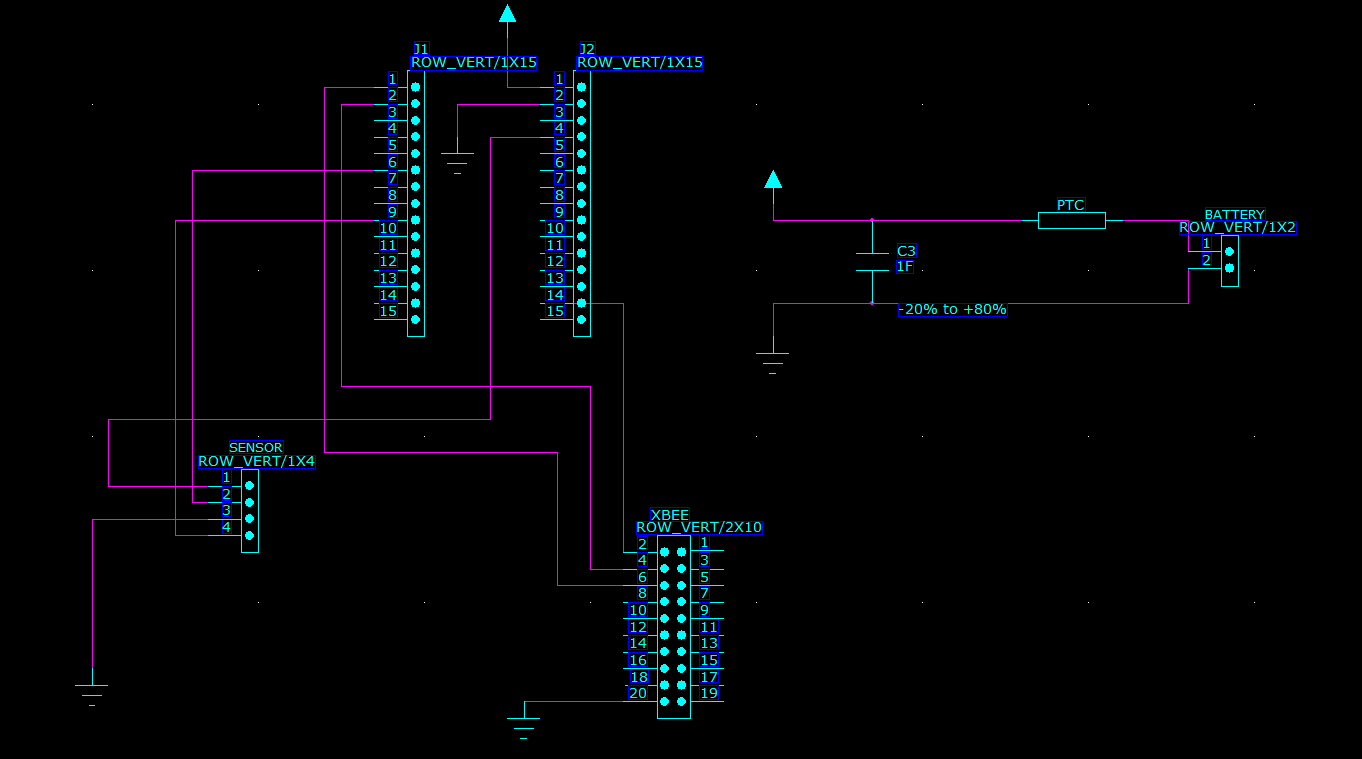
[picture p40: figure]

## PCB Design

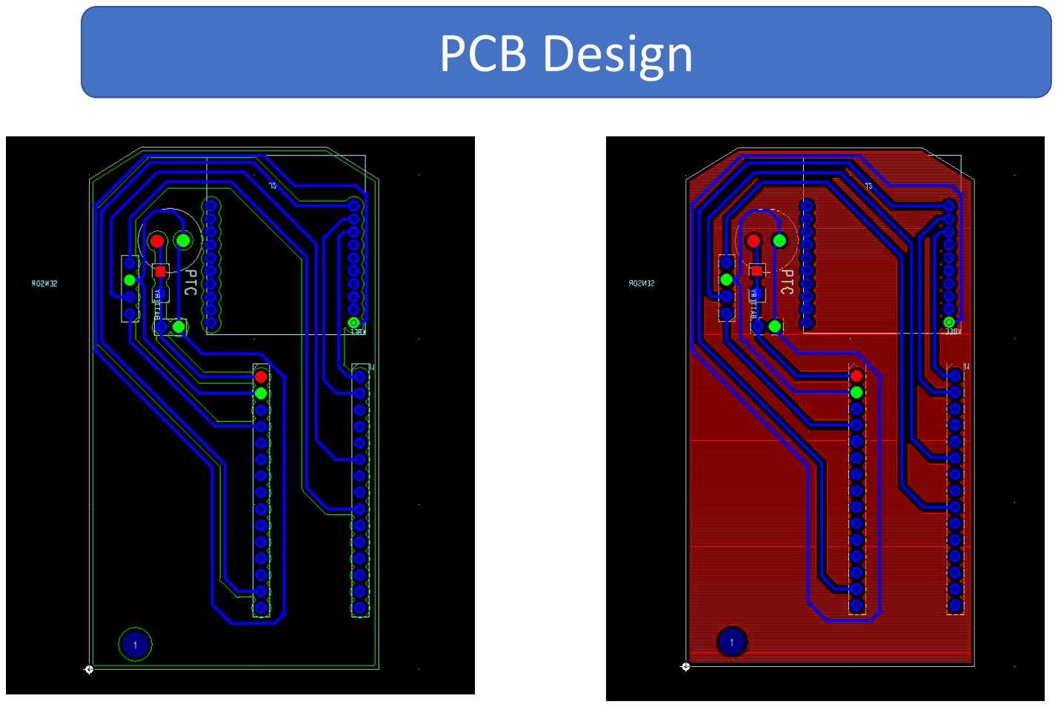
[picture p41: page 17]

# Principle of operation

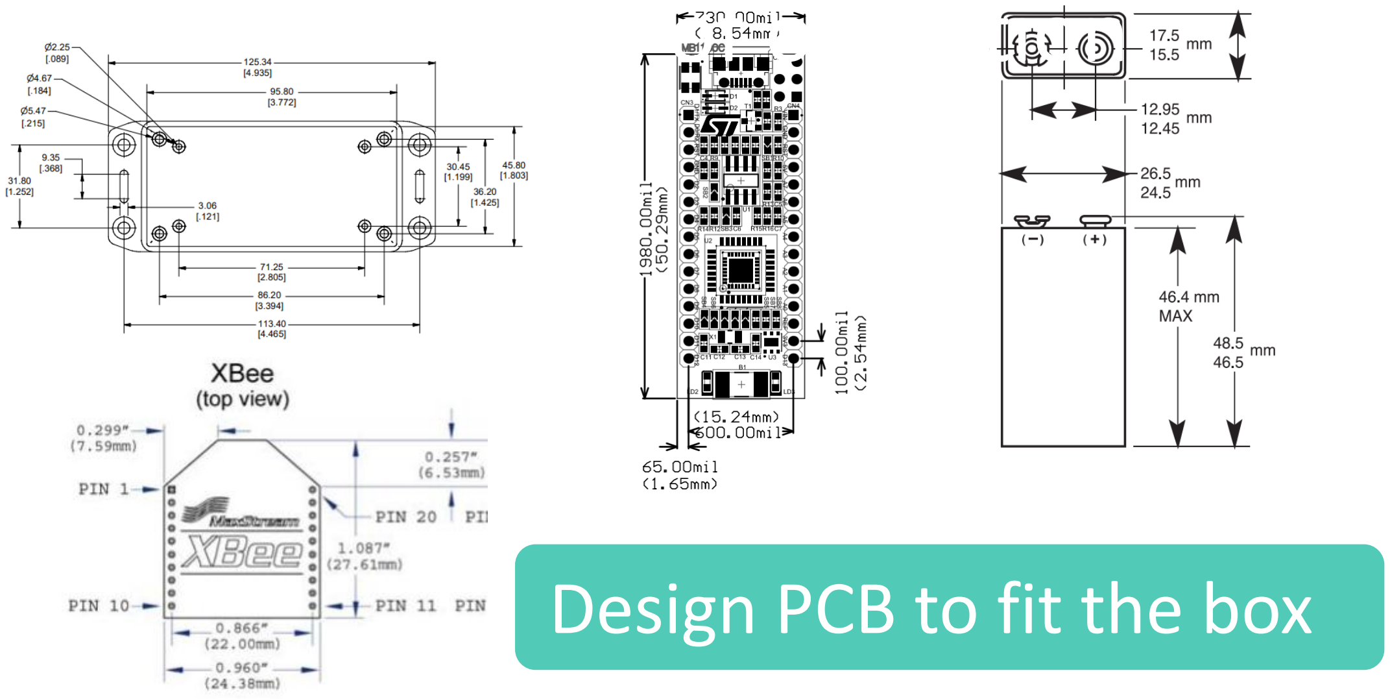
[picture p42: page 18]

# Design PCB to fit the box

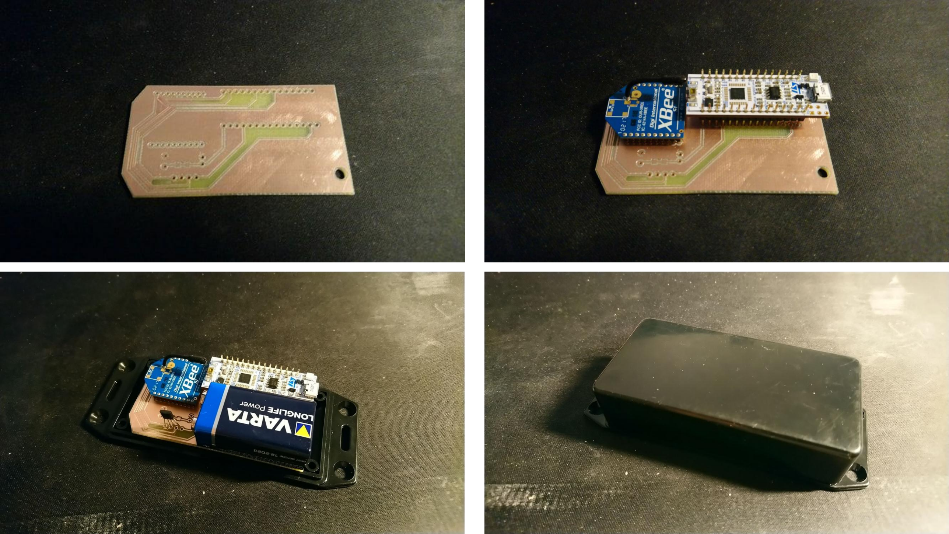
[picture p43: page 19]

## UART frame and checksum

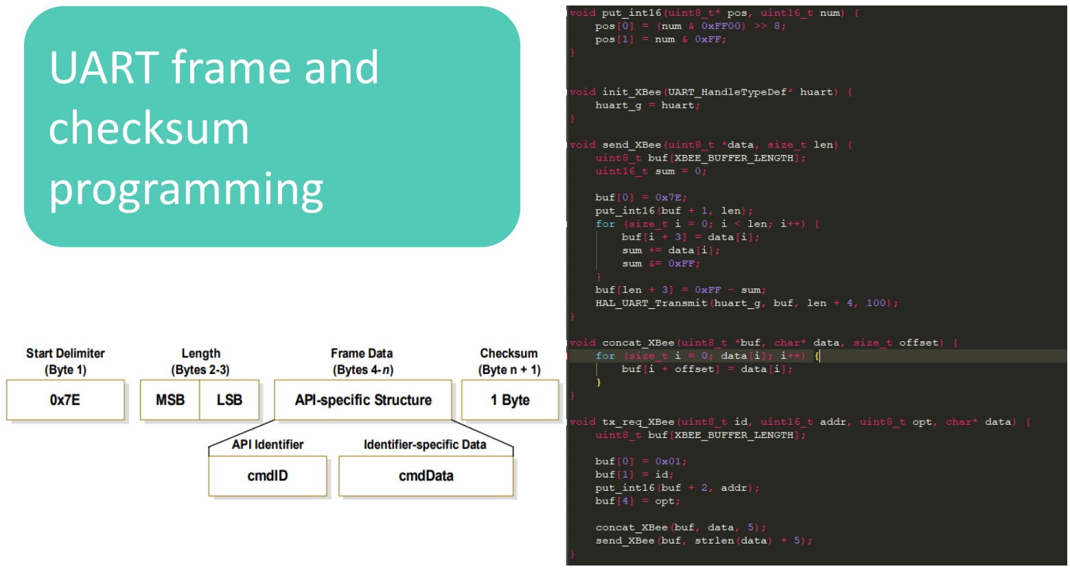
[picture p44: page 20]

## programming

## Sleep mode programming

## Sever programming

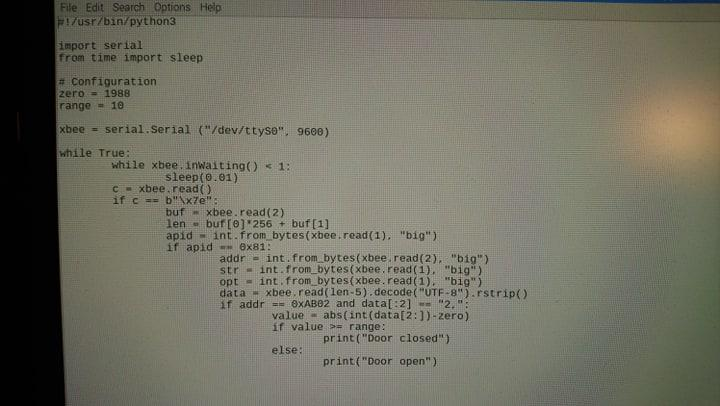
[picture p45: figure]

# Testing

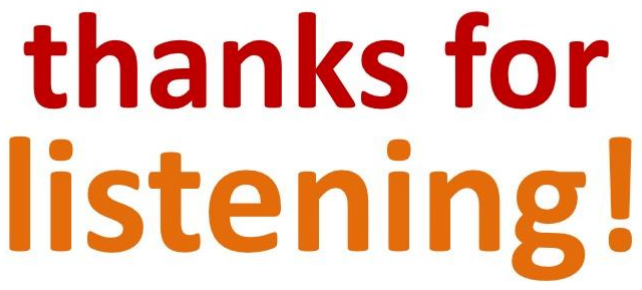
[picture p46: figure]
