quochuy2204/magnetic-sensor/doc/Parts.xlsx

Part type | Part name | Order code | Vendor (Elfa/Farnell) | Unit price | Number | Total price
Magnetic sensor | G-MRCO-028 |  |  |  | 1
Battery (9V) |  |  |  |  | 1
Battery holder |  |  |  |  | 1
XBee module |  |  |  |  | 1
STM32 controller | L432KC |  |  |  | 1
Plastic box | 1591A-FL |  | Starelec |  | 1
Resistor (1k) |  |  |  |  | 3
Resistor (10k) |  |  |  |  | 3
Ceramic capacitor (100nF) |  |  |  |  | 2
Electrolyte capacitor (10uF) |  |  |  |  | 1
Resettable fuse | MF-MSMF050-2 | 9350314RL | Farnell |  | 1
Trimmer (1k) |  |  |  |  | 1
OpAmp | LMC6482M |  |  |  | 1
