quochuy2204/magnetic-sensor/doc/LTSpice/sim1.asc

R1: res; 1k
R2: res; 1k
R3: res; 10k
R4: res; 10k
R5: res; 10k
R6: res; 1k
R7: res; 1k
U1: opamp2; LMC6482A/NS
U2: opamp2; LMC6482A/NS
Vbase: voltage; 1.6
Vsource: voltage; 3.3
Vsweep: voltage; 1.6
Named nets: Vcc, 0, Base, Sweep, Diff, Out, Ref
.dc Vsweep 1.6 1.7 100u
.include nat_semi.lib
