quochuy2204/magnetic-sensor/system/Src/main.c

/**
 ******************************************************************************
 * @file           : main.c
 * @brief          : Main program body
 ******************************************************************************
 ** This notice applies to any and all portions of this file
 * that are not between comment pairs USER CODE BEGIN and
 * USER CODE END. Other portions of this file, whether
 * inserted by the user or by software development tools
 * are owned by their respective copyright owners.
 *
 * COPYRIGHT(c) 2019 STMicroelectronics
 *
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
 ******************************************************************************
 */
/* Includes ------------------------------------------------------------------*/
#include "main.h"
#include "stm32l4xx_hal.h"

/* USER CODE BEGIN Includes */
#include "string.h"
#include "stdlib.h"
#include "XBee.h"
/* USER CODE END Includes */

ADC_HandleTypeDef hadc1;

UART_HandleTypeDef huart1;
UART_HandleTypeDef huart2;

/* USER CODE BEGIN PV */
char* com_buf[100];
int com_len;
/* USER CODE END PV */

void SystemClock_Config(void);
static void MX_GPIO_Init(void);
static void MX_USART2_UART_Init(void);
static void MX_ADC1_Init(void);
static void MX_USART1_UART_Init(void);

/* USER CODE BEGIN PFP */

/* USER CODE END PFP */

/**
 * @brief  The application entry point.
 *
 * @retval None
 */
int main(void) {
	/* MCU Configuration----------------------------------------------------------*/

	/* Reset of all peripherals, Initializes the Flash interface and the Systick. */
	HAL_Init();

	/* Configure the system clock */
	SystemClock_Config();

	/* Initialize all configured peripherals */
	MX_GPIO_Init();
	MX_USART2_UART_Init();
	MX_ADC1_Init();
	MX_USART1_UART_Init();
	/* USER CODE BEGIN 2 */
	char buf[100] = "";
	init_XBee(&huart1);

	memset(com_buf, 0, 100);
	com_len = 0;

//	HAL_UART_Receive_IT(&huart1, com_buf + (com_len++), 1);

	HAL_UART_Transmit(&huart1, "+++", 3, 100);
	memset(buf, 0, 100);
	HAL_UART_Receive(&huart1, buf, 3, 5000);
	HAL_UART_Transmit(&huart2, buf, 3, 100);

	/* USER CODE END 2 */

	/* Infinite loop */
	/* USER CODE BEGIN WHILE */
	while (1) {
		/* USER CODE END WHILE */

		/* USER CODE BEGIN 3 */
		HAL_ADC_Start(&hadc1);
		HAL_ADC_PollForConversion(&hadc1, 1000);
		int value = HAL_ADC_GetValue(&hadc1);
		HAL_ADC_Stop(&hadc1);
		value = abs(value - 1988);
		sprintf(buf, "Value: %d\r\n", value);
		HAL_UART_Transmit(&huart2, (uint8_t*) buf, strlen(buf), 100);

		tx_req_XBee(1, 0xAB01, 0, buf);
		HAL_Delay(5000);
	}
	/* USER CODE END 3 */

}

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
/* USER CODE BEGIN 4 */
void HAL_UART_RxCpltCallback(UART_HandleTypeDef *huart) {
	HAL_UART_Receive_IT(&huart1, com_buf + (com_len++), 1);
}
/* USER CODE END 4 */
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
