quochuy2204/magnetic-sensor/system/project_kc.ioc

Mcu.UserName=STM32L432KCUx
PA0.GPIO_Label=MCO [High speed clock in]
PA0.Signal=RCC_CK_IN
PA10.Signal=USART1_RX
PA2.GPIO_Label=VCP_TX
PA2.Signal=USART2_TX
PA9.Signal=USART1_TX
PB0.Signal=ADCx_IN15
PB1.Signal=ADCx_IN16
