quochuy2204/magnetic-sensor/(notices)

Notices in the files:
system/Src/main.c:
(C) COPYRIGHT STMicroelectronics *****END OF FILE
